Luciandraw/Beyblade-Dragoon-RPM/docs/assets/components-review.png

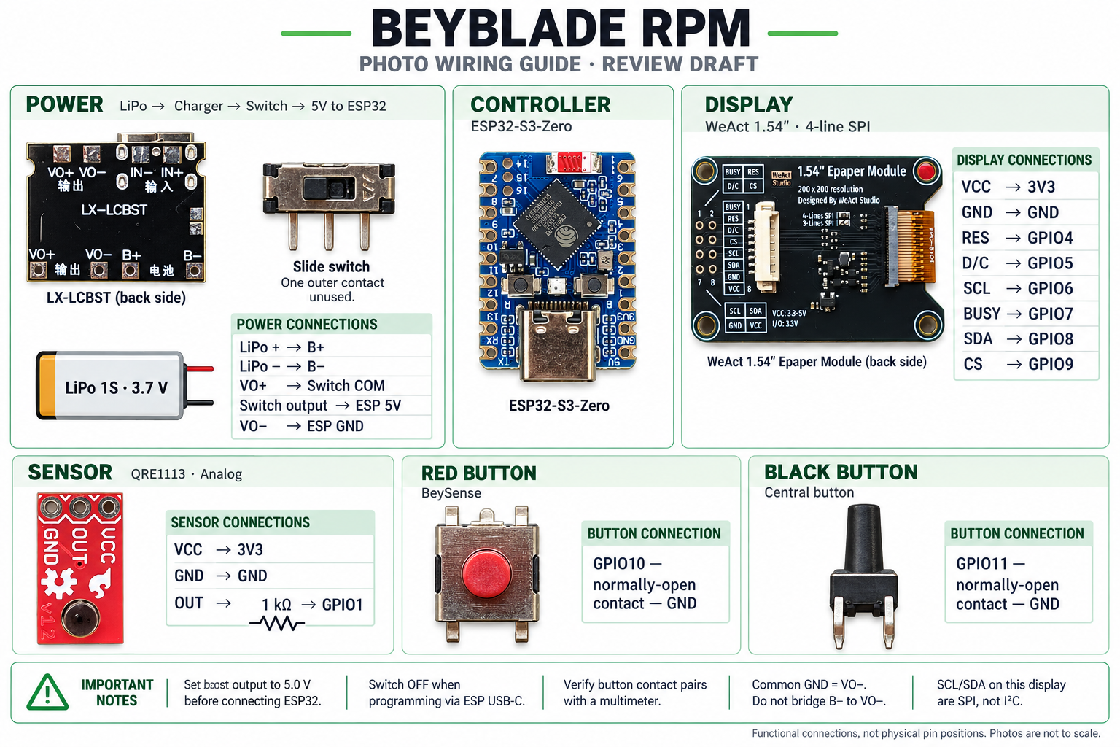
docs/assets/components-review.png
