Luciandraw/Beyblade-Dragoon-RPM/docs/assets/components-dark.png

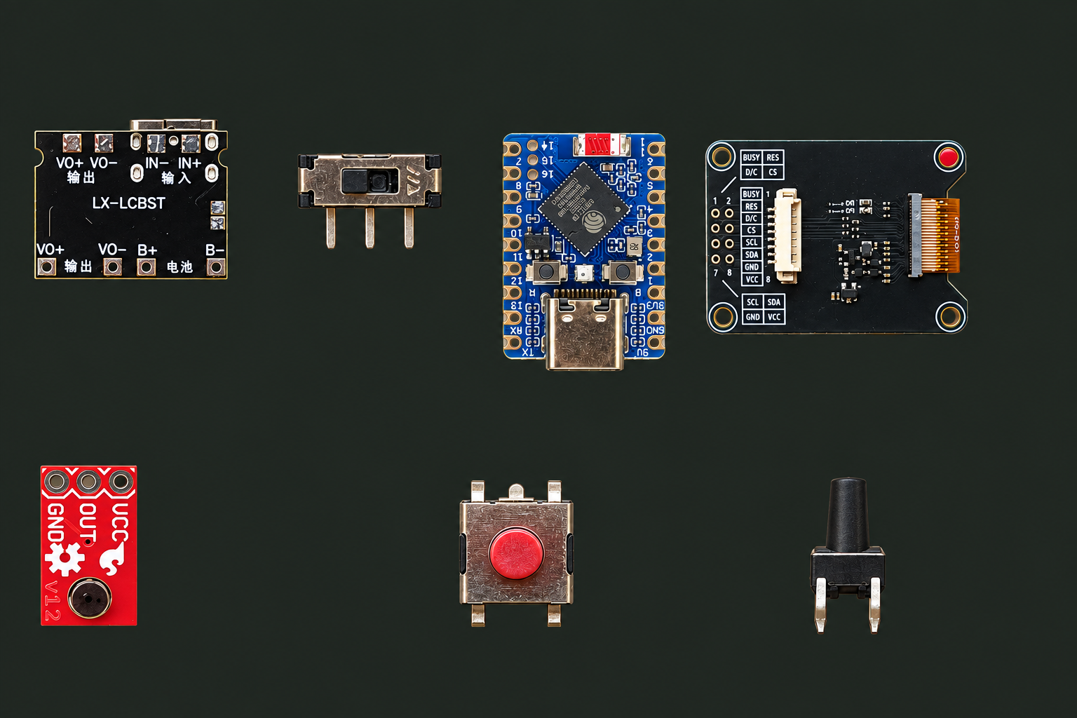
docs/assets/components-dark.png
