Luciandraw/Beyblade-Dragoon-RPM/README.md

# Beyblade X RPM Analyzer

An ESP32-S3-Zero launch-speed analyzer with an analog QRE1113 optical sensor and a 200 × 200 e-paper display. The sensor reads a half-white, half-black disk (one period per revolution). The firmware detects launches automatically, calculates average and peak RPM, and stores the last 20 results.

[Project website](https://luciandraw.github.io/Beyblade-Dragoon-RPM/) · [3D assembly](https://luciandraw.github.io/Beyblade-Dragoon-RPM/model.html) · [Wiring diagram](https://luciandraw.github.io/Beyblade-Dragoon-RPM/wiring.html) · [Screen emulator](https://luciandraw.github.io/Beyblade-Dragoon-RPM/screens.html)

## Website and firmware

The website (English and Polish, light and dark themes) includes an interactive wiring diagram, a 3D viewer with exploded assembly and wireframe modes, a screen emulator, and a browser-based USB installer.

The screen emulator ([docs/screens.html](docs/screens.html)) redraws every e-paper screen pixel for pixel: [docs/screens.mjs](docs/screens.mjs) mirrors [main/display.cpp](main/display.cpp) using the same Adafruit GFX font and primitives. When changing a layout, update both files. After changing a bitmap header, regenerate the assets with `python scripts/export-screen-assets.py <Adafruit_GFX_Library>/glcdfont.c`.

## Components and purchase links

Choose **one sourcing option per component**. These are separate shopping lists, not a combined basket. Check dimensions, connector pitch and pack size before ordering. Prices are indicative; see the [cost summary](#component-cost-summary).

### Poland

Prices below use Polish suppliers only.

| Component | Purchase unit | Buy in Poland | PLN |
|---|---|---|---:|
| ESP32-S3-Zero | 1 board | [Elektroweb][pl-esp] / [Allegro alternative](https://allegro.pl/produkt/sterownik-elektroweb-esp32-s3-zero-waveshare-wi-fi-2-4ghz-ble-ef6b7981-b6df-4aea-857e-138e2bef4ac1?offerId=18479170722) | 34.90 |
| Charge + DC-DC boost module | 1 module | [Allegro][pl-boost] | 4.90 |
| QRE1113 analog module | 1 module | [Botland][pl-sensor] | 21.90 |
| WeAct 1.54-inch, 200 × 200 e-paper | 1 display | [Elektroweb][pl-screen] / [Allegro alternative](https://allegro.pl/produkt/wyswietlacz-elektroweb-1-54-od-weact-spi-3-3v-5v-91174db3-afa0-4ec1-974b-52413aeab759?offerId=17700495465) | 42.70 |
| Central button, 6 × 6 × 13 mm | Pack of 5; one used | [Botland][pl-central] | 0.99 |
| BeySense blade-present button | Pack of 10; one used | [Allegro][pl-beysense] | 5.37 |
| SS22T35 power slide switch | Pack of 5; one used | [Botland][pl-switch] | 5.90 |
| LiPo battery, 602020, 3.7 V, 200 mAh | 1 battery | [Allegro][pl-battery] | 22.90 |
| **Total — all 8 listed components** | | | **139.56 zł ≈ $37.45** |

Prices refer to the first supplier in each row; alternative sellers are not counted again.

### Worldwide / AliExpress

All links below are AliExpress alternatives. Delivery availability, taxes and displayed prices depend on the destination country. USD values are conversions of PLN source prices, not US checkout quotes. Prices marked **~*** are historical price values embedded in the supplied AliExpress URLs, not verified current checkout prices. Their variant, pack size and discount eligibility are unconfirmed. Unmarked prices come from the supplied screenshots. The ESP32 screenshot price is a displayed special offer for one board with unsoldered headers; Polish prices are not substituted.

| Component | Buy on AliExpress / variant | PLN | USD equivalent |
|---|---|---:|---:|
| ESP32-S3-Zero | [1 board, unsoldered headers](https://www.aliexpress.com/item/1005006963045909.html) | 17.92 | $4.81 |
| Charge + DC-DC boost module | [Module](https://www.aliexpress.com/item/1005009566821602.html) | ~4.73* | ~$1.27* |
| QRE1113 analog module | [Sensor](https://www.aliexpress.com/item/1005008965289337.html) | ~4.89* | ~$1.31* |
| WeAct 1.54-inch, 200 × 200 e-paper | [Display](https://www.aliexpress.com/item/1005006291142235.html) | ~32.09* | ~$8.61* |
| Central momentary button | [6 × 6 × 12 mm](https://www.aliexpress.com/item/1005007324455095.html) | ~10.20* | ~$2.74* |
| BeySense blade-present button | [Button](https://www.aliexpress.com/item/1005005473521127.html) | ~5.92* | ~$1.59* |
| Power slide switch | [Switch](https://www.aliexpress.com/item/1005008240336192.html) / [MSK-12D19 alternative](https://www.aliexpress.com/item/4001202080623.html) | ~13.01* | ~$3.49* |
| LiPo battery | [1 battery, 602020, 3.7 V, 200 mAh](https://www.aliexpress.com/item/32664248150.html) | 21.89 | $5.87 |
| **Indicative total — all 8 listed components** | | **~110.65 zł** | **~$29.69** |

*Saved URL prices may apply to a different variant or promotional offer. The estimate counts each saved listing price once per row, not a verified pack quantity. The MSK-12D19 alternative has a saved price of **~7.39 zł (~$1.98)** and is not added to the subtotal.*

### Before ordering

- **No separate pin headers or assembly board are required.** Use the wires supplied with the display for the display connection.
- Required enclosure fasteners: **6 × M2 × 12 mm screws**, **2 × M2 × 4 mm screws**  and **4 × M3 × 6 mm screws**. Screw prices are not included in the component budget.
- Switch alternatives may differ in footprint and contact arrangement. Confirm fit and identify the common/switched contacts before wiring.
- Check the battery's permitted charge current against the charger configuration; do not assume a module's default setting is suitable for a small 200 mAh cell. Set the boost output to **5.0 V before connecting the ESP32**.
- Also allow for the 1 kΩ sensor resistor, wire, solder, fasteners and printed enclosure. These were not priced in the supplied shopping list.

## Pinout

| Signal | ESP32-S3-Zero |
|---|---|
| QRE1113 OUT through 1 kΩ | GPIO1 (ADC1_CH0) |
| E-paper RES | GPIO4 |
| E-paper D/C | GPIO5 |
| E-paper SCL | GPIO6 |
| E-paper BUSY | GPIO7 |
| E-paper SDA | GPIO8 |
| E-paper CS | GPIO9 |
| Blade-present button → GND | GPIO10 |
| Central button → GND | GPIO11 |

Power the QRE1113 and e-paper from `3V3` in this build, with a common ground. Display `SCL` and `SDA` mean **SPI SCK and MOSI**, not I²C. Keep the display in 4-line SPI mode.

Connect the LiPo to `B+`/`B-` on the charge-and-boost module. Before connecting the ESP32, use a multimeter to adjust the output between `VO+` and `VO-` to **5.0 V**. Connect `VO+` through the power switch to ESP32 `5V`, and `VO-` directly to GND. USB-C charging remains available with the device switched off. Keep the power switch off when connecting the ESP32 to a computer over USB.

## Arduino IDE

1. Install **esp32 by Espressif Systems** and **GxEPD2 by Jean-Marc Zingg**. The packaged export uses ESP32 core **3.3.11**.
2. Open [main/main.ino](main/main.ino) and select `Waveshare ESP32-S3-Zero`.
3. Select USB Mode `Hardware CDC and JTAG`, `USB CDC On Boot: Enabled`, Flash Mode `QIO 80MHz`, PSRAM `Disabled` (matching the tested build), and Partition Scheme `Default 4MB with spiffs`.
4. When switching from another board profile for the first time, enable `Erase All Flash Before Sketch Upload`, upload, then return it to `Disabled`. This clears saved data.
5. Select the COM port, upload the sketch, and open Serial Monitor at 115200 baud if diagnostics are needed.

The project also includes a PlatformIO configuration: `platformio.ini` sets `src_dir = main`. The packaged release is the Arduino IDE export, not a separately verified PlatformIO build.

## Operation

Startup uses thresholds measured on the assembled device and stored in `config.h`; a separate calibration step is no longer required. Manual calibration remains available if sensor position or lighting changes. A successful manual calibration is saved to NVS and restored after sleep and reboot; clearing the launch history keeps it. In `SENSOR ALIGN`, adjust the gap to approximately 0.5–1.5 mm and shield the sensor from ambient light.

The device initially shows `INSERT BLADE`. The blade-present button on GPIO10 must connect to GND when a blade is installed; the display then shows `READY`. The armed state is latched, so releasing the button during launch does not cancel measurement.

A launch starts after three same-direction QRE1113 transitions within 200 ms. Measurement ends after 250 ms without transitions. This limits very slow rotation measurements regardless of the filter's 10 RPM lower bound. The display and NVS are not updated during measurement. The e-paper is drawn by a separate FreeRTOS task on core 0, so a refresh no longer blocks ADC processing; a newer screen replaces one that has not started drawing yet.

### Power and sleep

- The ADC stream and full 240 MHz CPU speed run only while a launch can be measured (READY with a blade, measuring), during calibration, and on the service screen. Otherwise the ADC is stopped and the CPU runs at 80 MHz.
- After 60 seconds without activity the device shows the logo and enters deep sleep. It wakes on the center button or, if no blade was seated, on inserting a blade (GPIO10, ext1 wake); a blade wake goes straight to the armed READY screen.
- Battery voltage cannot be measured without additional wiring.

### Central button

- Short press: open the menu or move to the next item.
- Double-click (up to 350 ms between clicks): confirm selection.
- Hold approximately 1 second: go back or recalibrate from READY.
- Hold approximately 3 seconds: open the service screen.

The service screen does not refresh automatically, so e-paper updates do not interfere with fast transition counting. Pull the launcher, then press briefly to refresh readings. Hold approximately one second to exit.

The menu includes launch history, the latest launch graph, calibration, and history clearing with confirmation.

## Configuration and measurement assumptions

Parameters in [main/config.h](main/config.h) include GPIO assignments, ADC rate, contrast, hysteresis, `SENSOR_INVERTED`, filters, RPM limits, periods per revolution, and `DRIVE_RATIO`.

The calculation uses LOW → HIGH transitions only:

```text
RPM = 60000000 × DRIVE_RATIO / (periodUs × ENCODER_PERIODS_PER_REV)
```

For the half-white, half-black disk, there is one period per revolution and the drive ratio is 1:1.

ADC sampling uses ESP-IDF continuous DMA configured for 80 kHz. This is a configured rate, not an independently measured rate. If initial DMA setup fails, sampling falls back to slower `analogRead()`.

Measurement stability measures:

- ADC filtering and hysteresis with 75 µs transition confirmation. The timestamp is recorded at the start of confirmation.
- An impossibly early pulse does not shift the start of the next period.
- Sharp acceleration is not rejected solely because of a percentage RPM jump.
- A DMA timestamp slightly ahead of the clock does not trigger a false timeout.
- `PEAK` is the median of the three fastest individual revolutions; with two revolutions, it uses the maximum. Current speed and the graph use a median of up to five periods. `AVG` uses the total duration of accepted periods.
- A 64-frame DMA buffer. Overflow, read errors, or long pauses break the stream: unfinished measurements are reset, and no revolution is calculated across missing data.

The firmware does not automatically double RPM after a long period: a single optical channel cannot unambiguously distinguish a missed revolution from slowing.

## Component cost summary

.Prices and stock may change, and indexed listings may lag behind checkout.

| Sourcing option | Priced items | Amount PLN | Amount USD | Status / limitations |
|---|---|---:|---:|---|
| **Poland** | 8 of 8 | **139.56 zł** | **$37.45** | All listed components included; shipping and assembly supplies excluded |
| **Worldwide / AliExpress** | 8 of 8; 6 URL estimates | **~110.65 zł** | **~$29.69** | All listed components included; estimated variants/pack sizes need confirmation |

**Both totals cover the 8 listed components. AliExpress remains an indicative estimate, not a verified checkout total.** The two shopping lists are independent: do not add their amounts together. Full packs are counted where specified, rather than just the individual parts consumed in one build.
 **screws** are not priced and must be budgeted separately.

Shipping, additional checkout charges, tools, enclosure printing and unlisted assembly supplies are excluded. 

## License

- **Firmware, website and scripts** (`main/`, `diagnostics/`, `docs/` code, `scripts/`, `platformio.ini`): [MIT License](LICENSE).
- **3D model files** (`docs/models/`, and the STL / 3MF print files): [CC BY-NC-SA 4.0](docs/models/LICENSE.txt), free to print and remix with credit, no commercial use, remixes under the same license. The printable files are published free on MakerWorld and Cults3D.
  
Independent fan project, not affiliated with Takara Tomy or Hasbro. Beyblade is a trademark of its respective owners.

[pl-esp]: https://elektroweb.pl/pl/minikomputery/2250-esp32-s3-zero-waveshare-wi-fi-24ghz-ble-spi-i2c-uart-i2s-adc-micropython.html
[pl-boost]: https://allegro.pl/produkt/ladowarka-li-ion-tp4056-z-przetwornica-dc-4-3-28v-97401841-c49c-4884-a7b6-5f43c8eaeeaa?offerId=15794012707
[pl-sensor]: https://botland.com.pl/czujniki-odbiciowe/7684-qre1113-czujnik-odbiciowy-analogowy-sparkfun-rob-09453-5904422304867.html
[pl-screen]: https://elektroweb.pl/pl/e-paper/2072-wyswietlacz-e-paper-200x200-czarno-bialy-154-od-weact-spi-33v-5v.html
[pl-central]: https://botland.com.pl/tact-switch/380-tact-switch-6x6mm-13mm-tht-5szt-5904422307608.html
[pl-beysense]: https://allegro.pl/produkt/tact-switch-smd-6x6mm-h-3-4mm-czerwony-niski-3d75d2bf-592b-4ecc-8c0d-1ee1b312e8ed?offerId=7883778097
[pl-switch]: https://botland.com.pl/przelaczniki-suwakowe-i-przesuwne/8052-przelacznik-suwakowy-ss22t35-2-pozycyjny-5szt-5904422336172.html
[pl-battery]: https://allegro.pl/oferta/akumulator-pryzmatyczny-3-7v-200mah-lipo-602020-4404-18813108295
