Luciandraw/Beyblade-Dragoon-RPM/docs/assets/blade-original.jpg

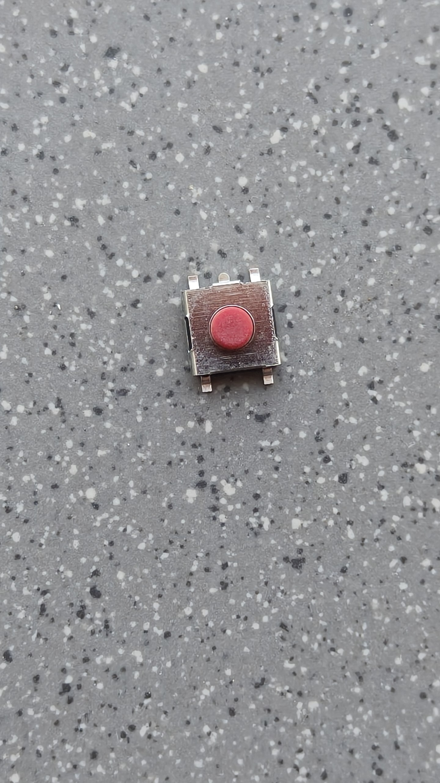
docs/assets/blade-original.jpg
