Luciandraw/Beyblade-Dragoon-RPM/docs/assets/center-original.jpg

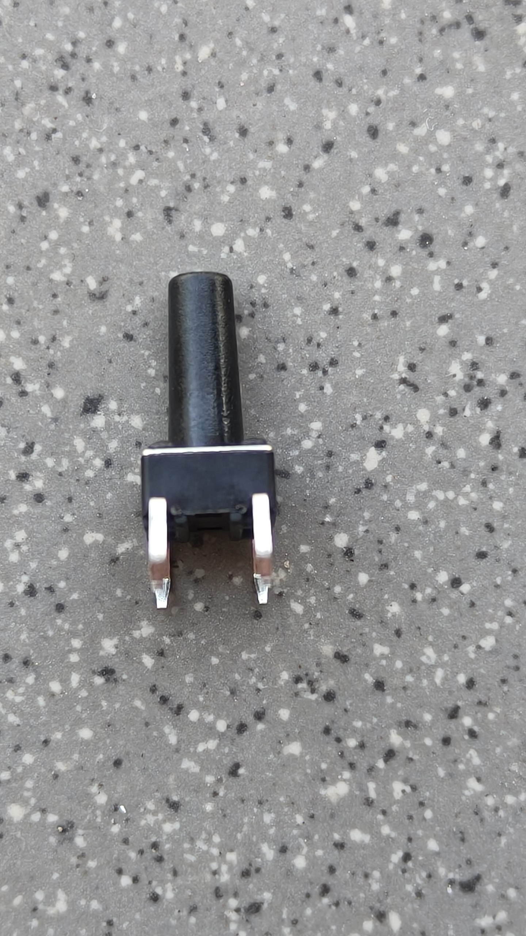
docs/assets/center-original.jpg
