Luciandraw/Beyblade-Dragoon-RPM/docs/assets/display-original.jpg

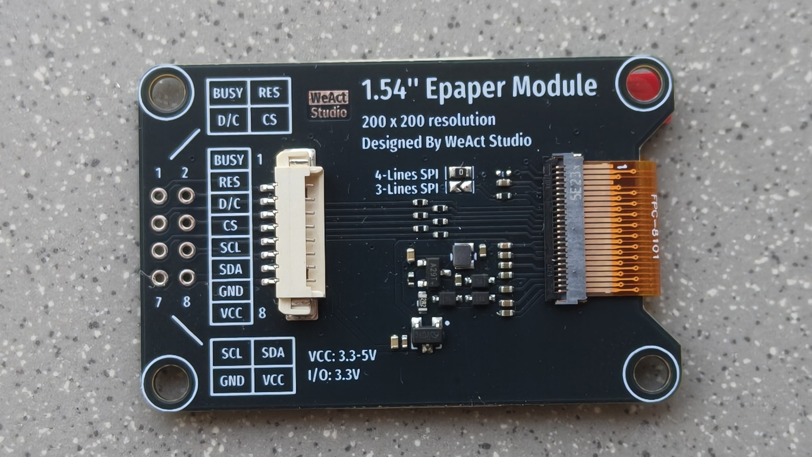
docs/assets/display-original.jpg
