Luciandraw/Beyblade-Dragoon-RPM/docs/assets/esp-original.jpg

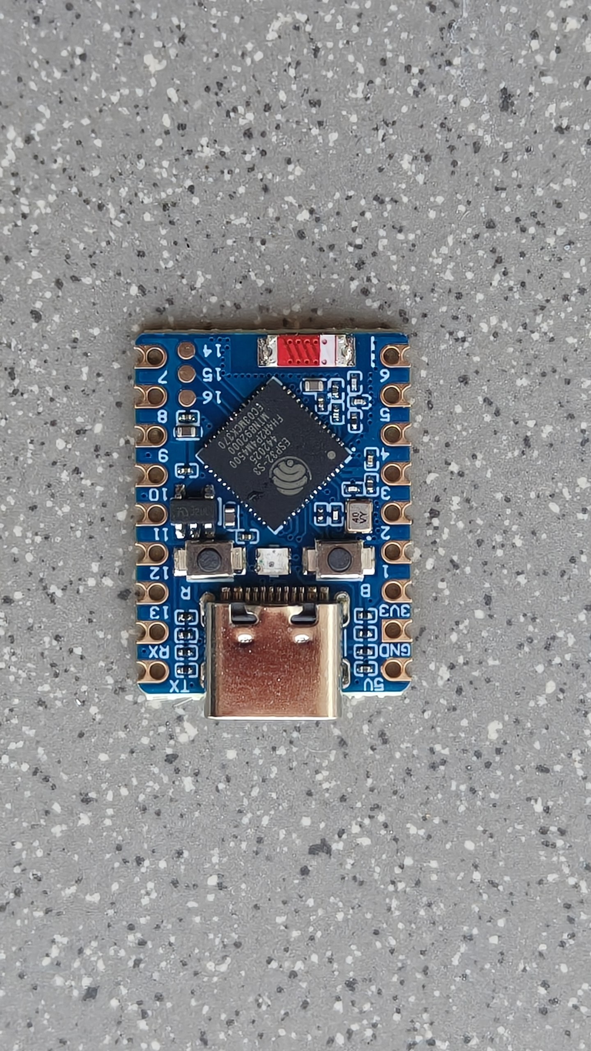
docs/assets/esp-original.jpg
