Luciandraw/Beyblade-Dragoon-RPM/docs/assets/power-original.jpg

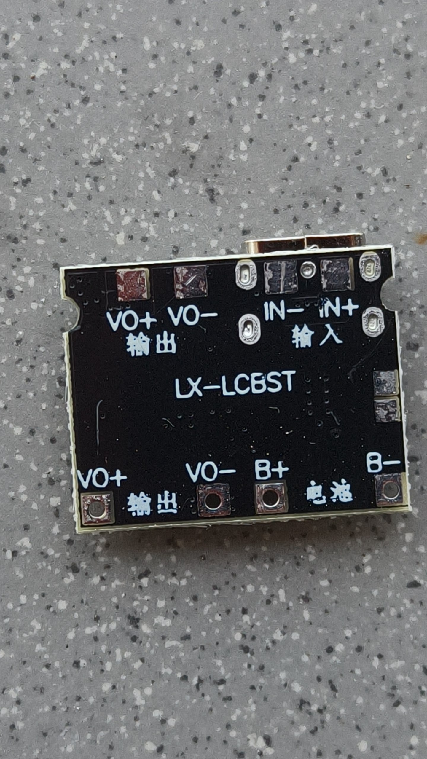
docs/assets/power-original.jpg
