Luciandraw/Beyblade-Dragoon-RPM/docs/assets/sensor-original.jpg

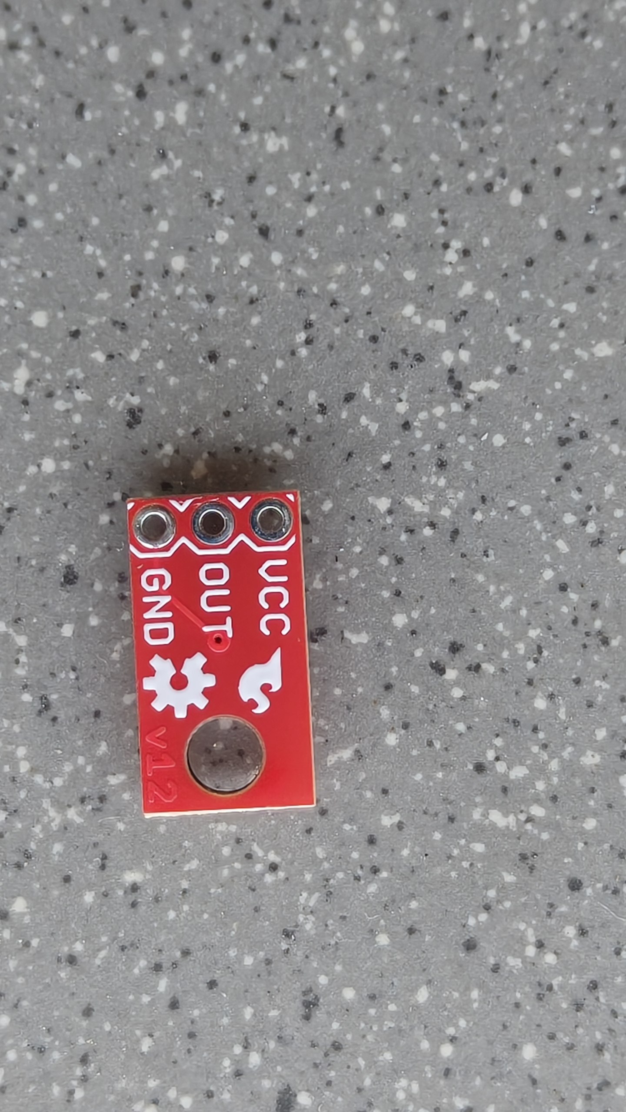
docs/assets/sensor-original.jpg
