Luciandraw/Beyblade-Dragoon-RPM/docs/assets/switch-original.jpg

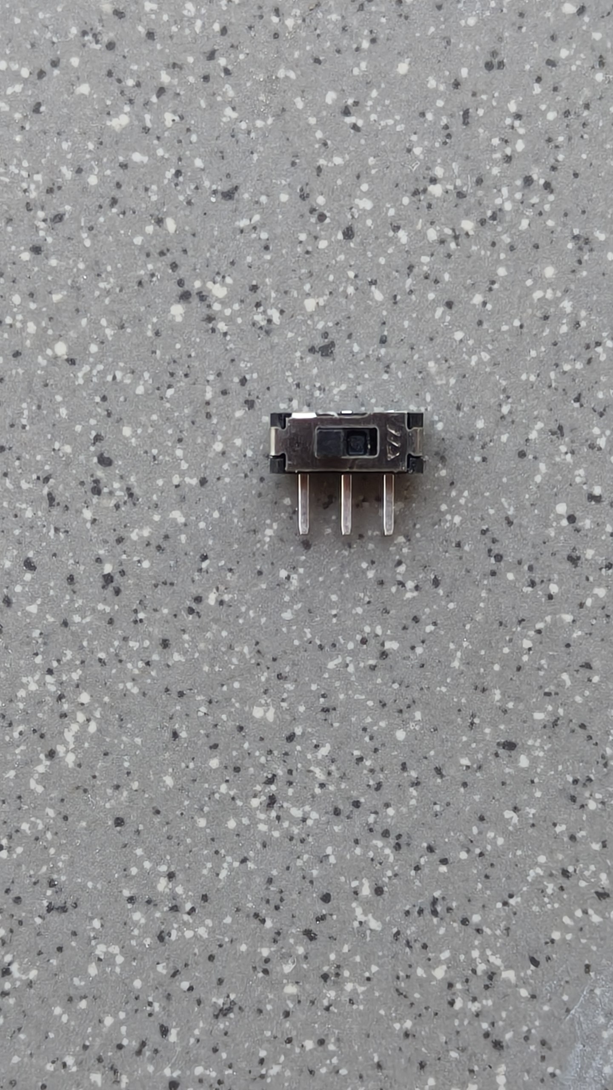
docs/assets/switch-original.jpg
