Luciandraw/Beyblade-Dragoon-RPM/docs/launcher-background.png

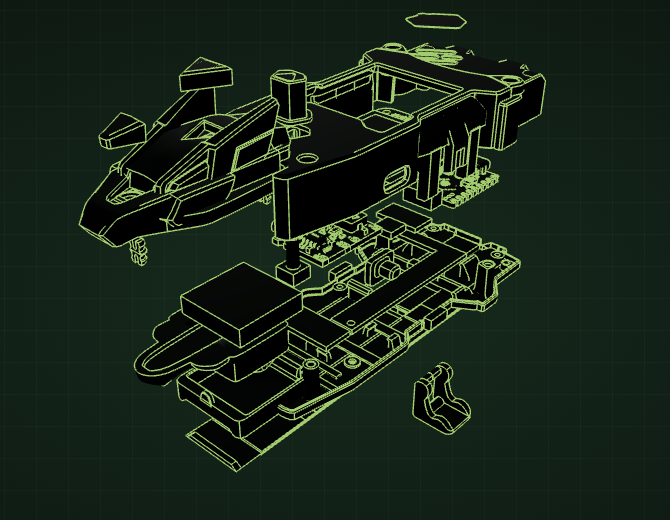
docs/launcher-background.png
