Luciandraw/Beyblade-Dragoon-RPM/main/blade_icon.h

#pragma once

#include <Arduino.h>

constexpr uint16_t BLADE_ICON_WIDTH = 38;
constexpr uint16_t BLADE_ICON_HEIGHT = 38;
constexpr uint8_t BLADE_ICON_BITMAP[] PROGMEM = {
  0x00, 0x00, 0x00, 0x00, 0x00, 0x00, 0x00, 0x00, 0x00, 0x00, 0x00, 0x00, 0x00, 0x10, 0x00,
  0x00, 0x00, 0x00, 0x30, 0x00, 0x00, 0x00, 0x08, 0x60, 0x00, 0x00, 0x20, 0x19, 0xC0, 0x00,
  0x00, 0x20, 0x73, 0xC0, 0x00, 0x00, 0x60, 0xE7, 0x80, 0x00, 0x00, 0x63, 0xCF, 0x00, 0x00,
  0x00, 0x6F, 0xBF, 0xC0, 0x00, 0x00, 0xFF, 0x3F, 0xF0, 0x00, 0x00, 0xFE, 0x01, 0xF8, 0x00,
  0x20, 0xFC, 0x30, 0xFE, 0x00, 0x30, 0xF8, 0xFE, 0x7F, 0x00, 0x1C, 0xF3, 0xFF, 0x3F, 0x80,
  0x0E, 0xF3, 0xFF, 0x3D, 0xC0, 0x0E, 0xE7, 0xFF, 0x9C, 0x40, 0x06, 0xE7, 0xFF, 0x9D, 0x00,
  0x06, 0xE7, 0xFF, 0x9D, 0x80, 0x02, 0xE7, 0xFF, 0x9D, 0x80, 0x08, 0xE7, 0xFF, 0x9D, 0xC0,
  0x0E, 0xF3, 0xFF, 0x3D, 0xC0, 0x07, 0xF3, 0xFF, 0x3C, 0xE0, 0x03, 0xF8, 0xFC, 0x7C, 0x30,
  0x01, 0xFC, 0x30, 0xFC, 0x10, 0x00, 0x7E, 0x01, 0xFC, 0x00, 0x00, 0x3F, 0xF3, 0xFC, 0x00,
  0x00, 0x0F, 0xF7, 0xD8, 0x00, 0x00, 0x03, 0xCF, 0x18, 0x00, 0x00, 0x07, 0x9C, 0x18, 0x00,
  0x00, 0x0F, 0x38, 0x10, 0x00, 0x00, 0x0E, 0x60, 0x10, 0x00, 0x00, 0x18, 0x40, 0x00, 0x00,
  0x00, 0x30, 0x00, 0x00, 0x00, 0x00, 0x20, 0x00, 0x00, 0x00, 0x00, 0x00, 0x00, 0x00, 0x00,
  0x00, 0x00, 0x00, 0x00, 0x00, 0x00, 0x00, 0x00, 0x00, 0x00,
};
