Luciandraw/Beyblade-Dragoon-RPM/(commit log)

2026-09-13 - upd
    [partitions.csv]
2026-10-15 Firmware 1.1.0, Game Boy screens, dark theme and screen emulator
    Firmware:
    - Save manual sensor calibration to NVS and restore it after sleep and reboot
    - Wake from deep sleep on blade insertion (ext1) as well as the center button
    - Draw the e-paper on a FreeRTOS task on core 0 so refreshes never stall ADC
    - Run the ADC and 240 MHz CPU only while a launch can be measured
    - Restyle all screens in the website's Game Boy look
    Site:
    - Light/dark theme with a header toggle
    - Screen emulator page mirroring main/display.cpp pixel for pixel
    - Publish the hardware-tested 1.1.0 build in the USB installer
2026-10-15 Firmware 1.1.0, Game Boy screens, dark theme and screen emulator
    (cherry picked from commit b106280334136c7e3af4da79f2adbf855ae5826b)
    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
